hotwolf/Mini-BDM-Pod/RevB/Mini-BDM-Pod RevB Schematic.pdf

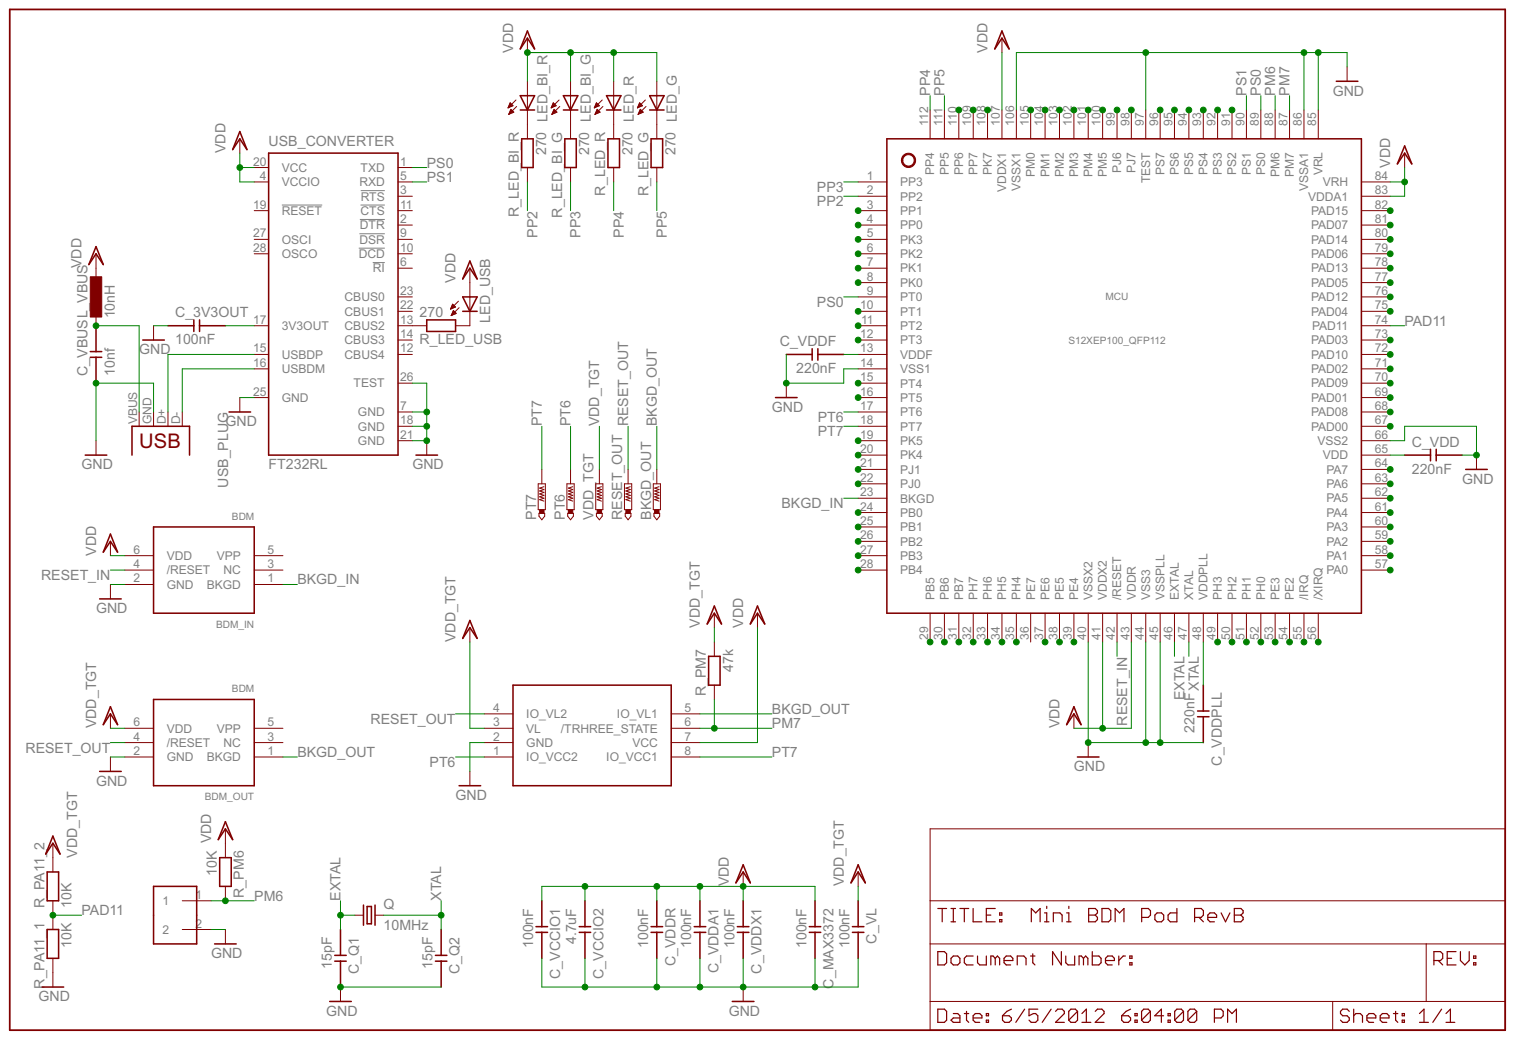
[picture p1: page 1]
