hotwolf/Mini-BDM-Pod/RevB/Mini-BDM-Pod RevB Mounting Plan.pdf

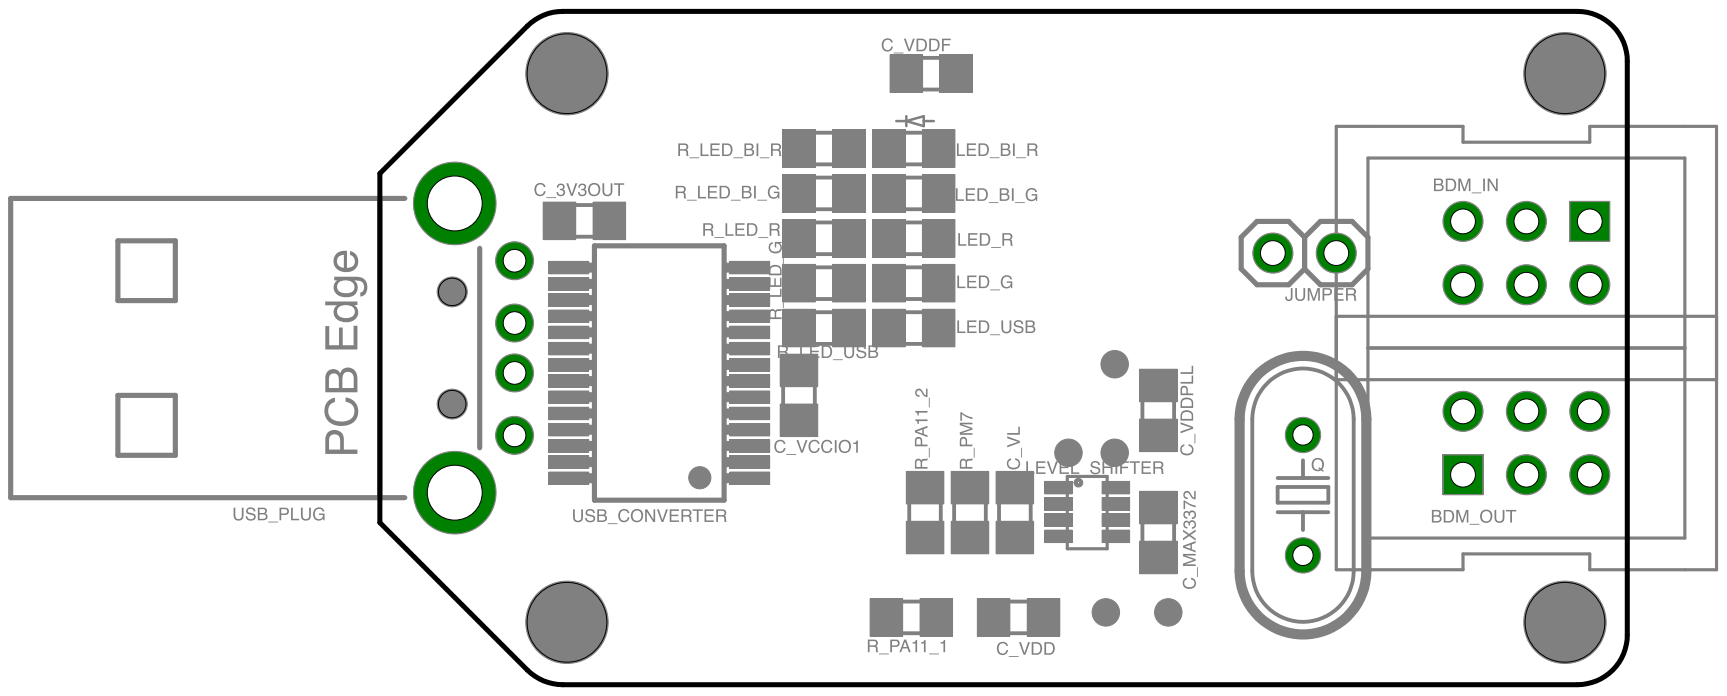
[picture p2: page 1]

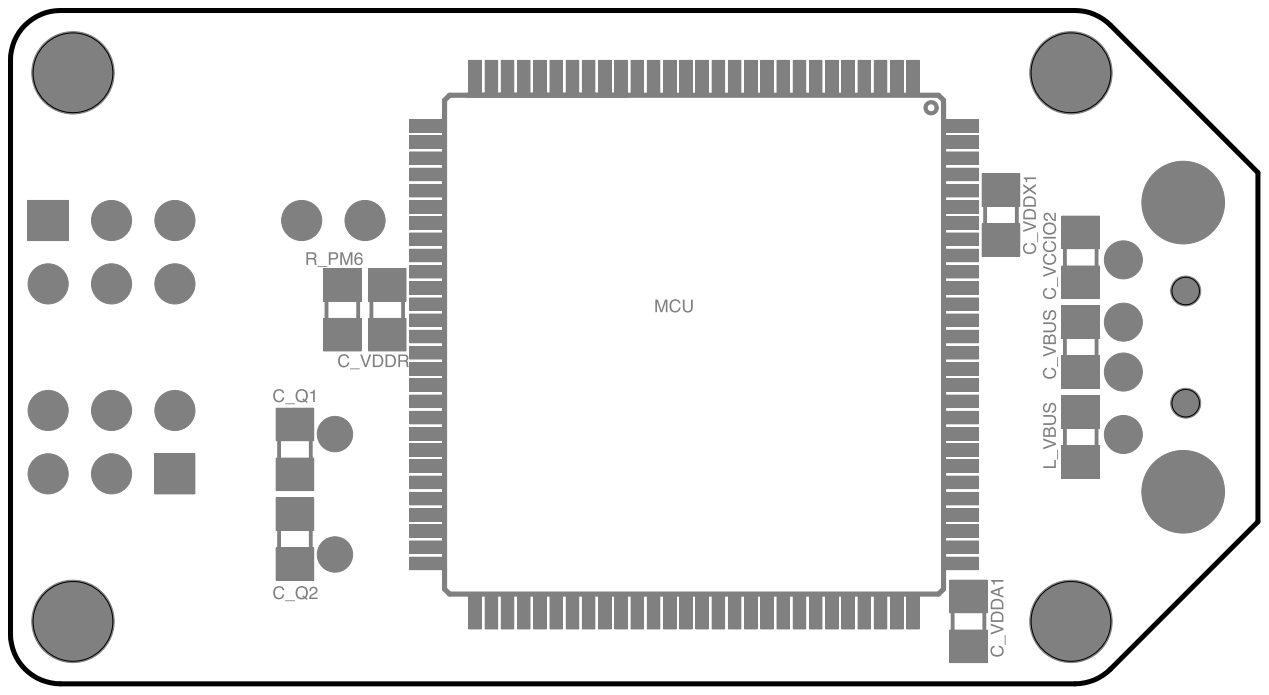
[picture p3: page 2]
