hotwolf/Mini-BDM-Pod/RevA/Mini-BDM-Pod RevA Schematic.pdf

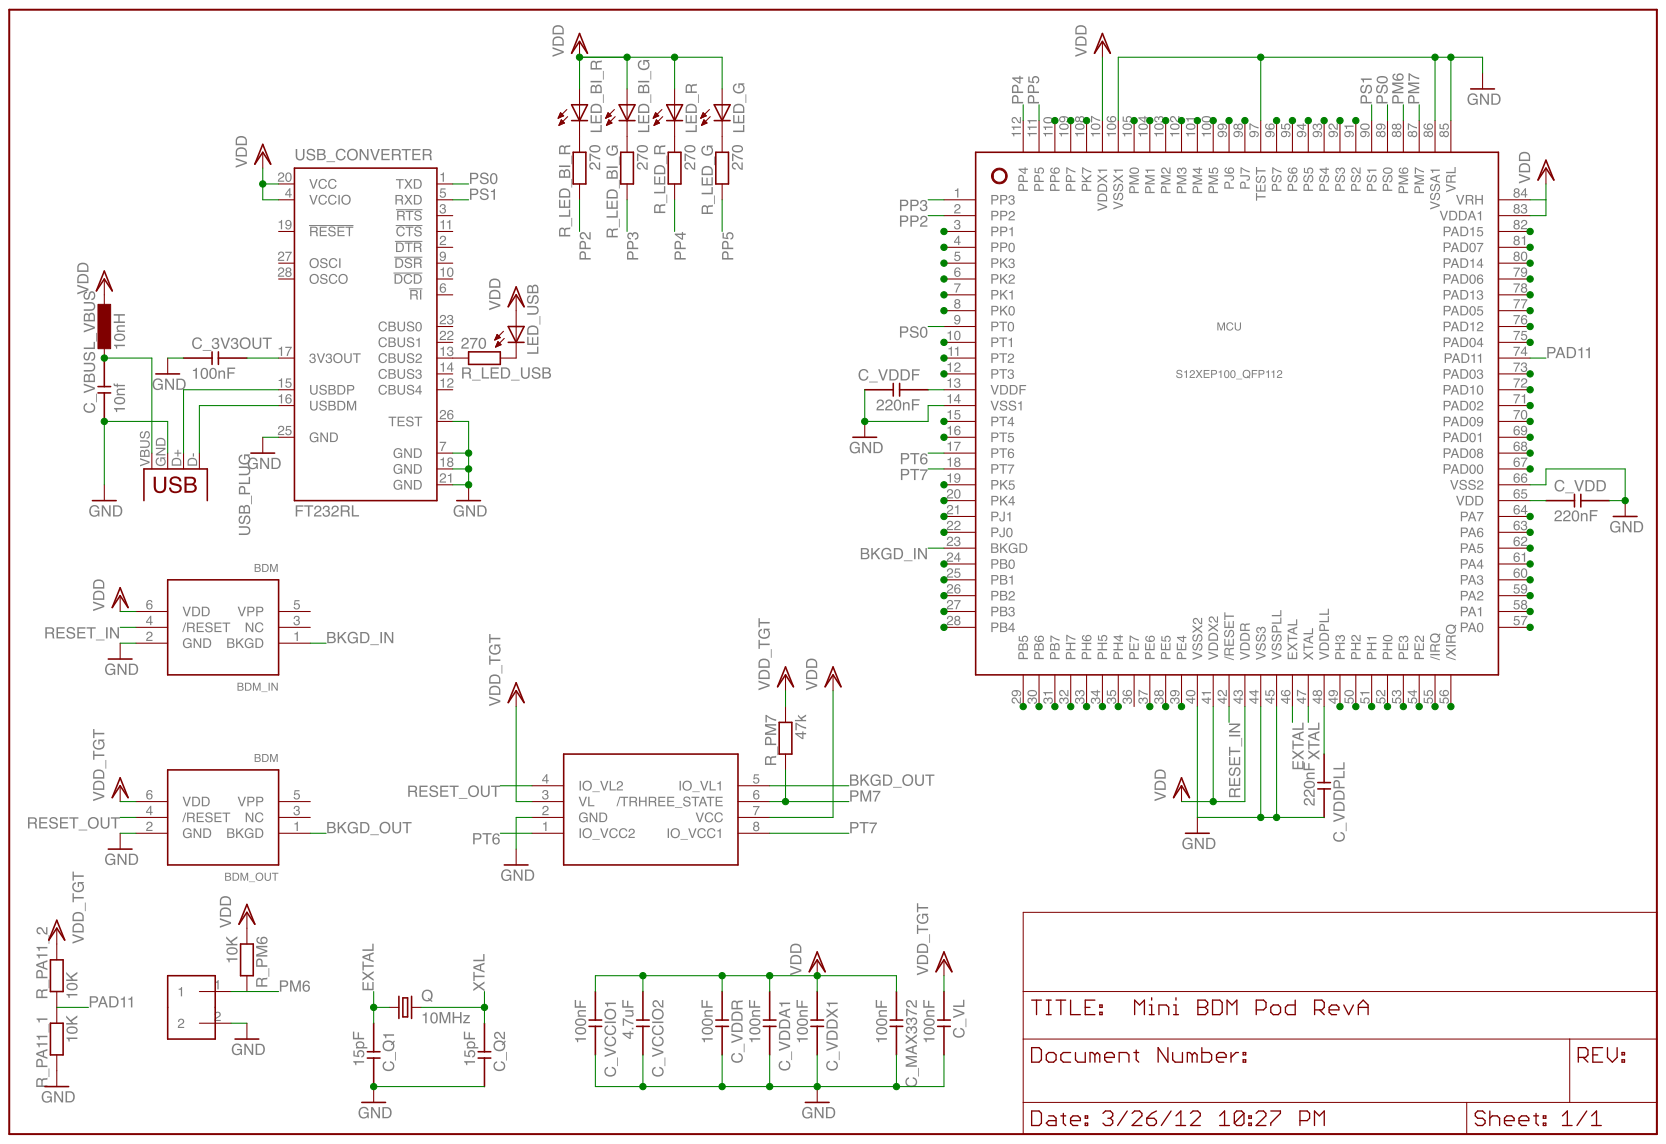
[picture p4: page 1]
