hotwolf/Mini-BDM-Pod/RevA/Mini-BDM-Pod RevA Mounting Plan.pdf

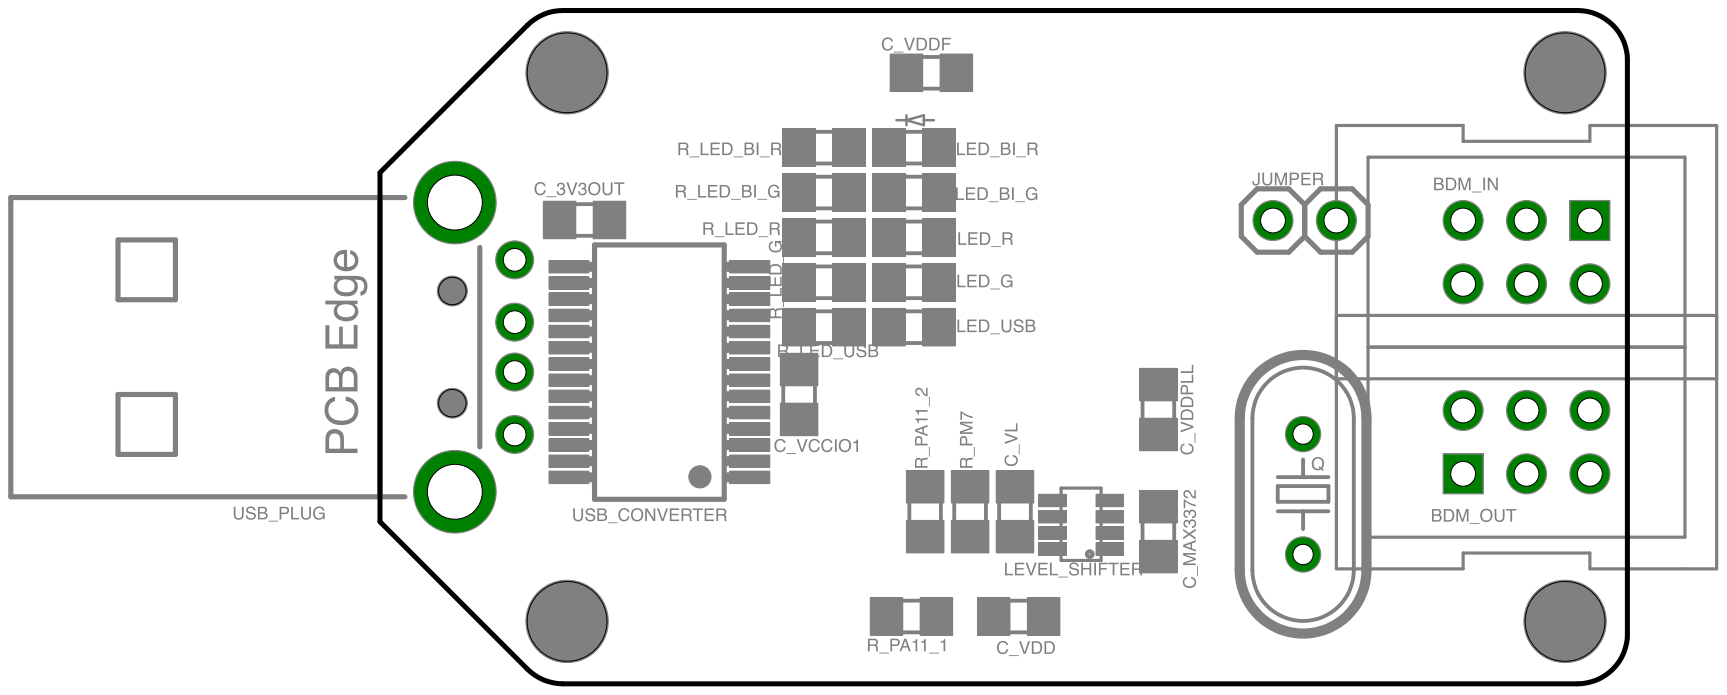
[picture p5: page 1]
