hotwolf/Mini-BDM-Pod/RevB/Mini-BDM-Pod RevB.brd

## EAGLE design RevB/Mini-BDM-Pod RevB.brd (2014-12-10)

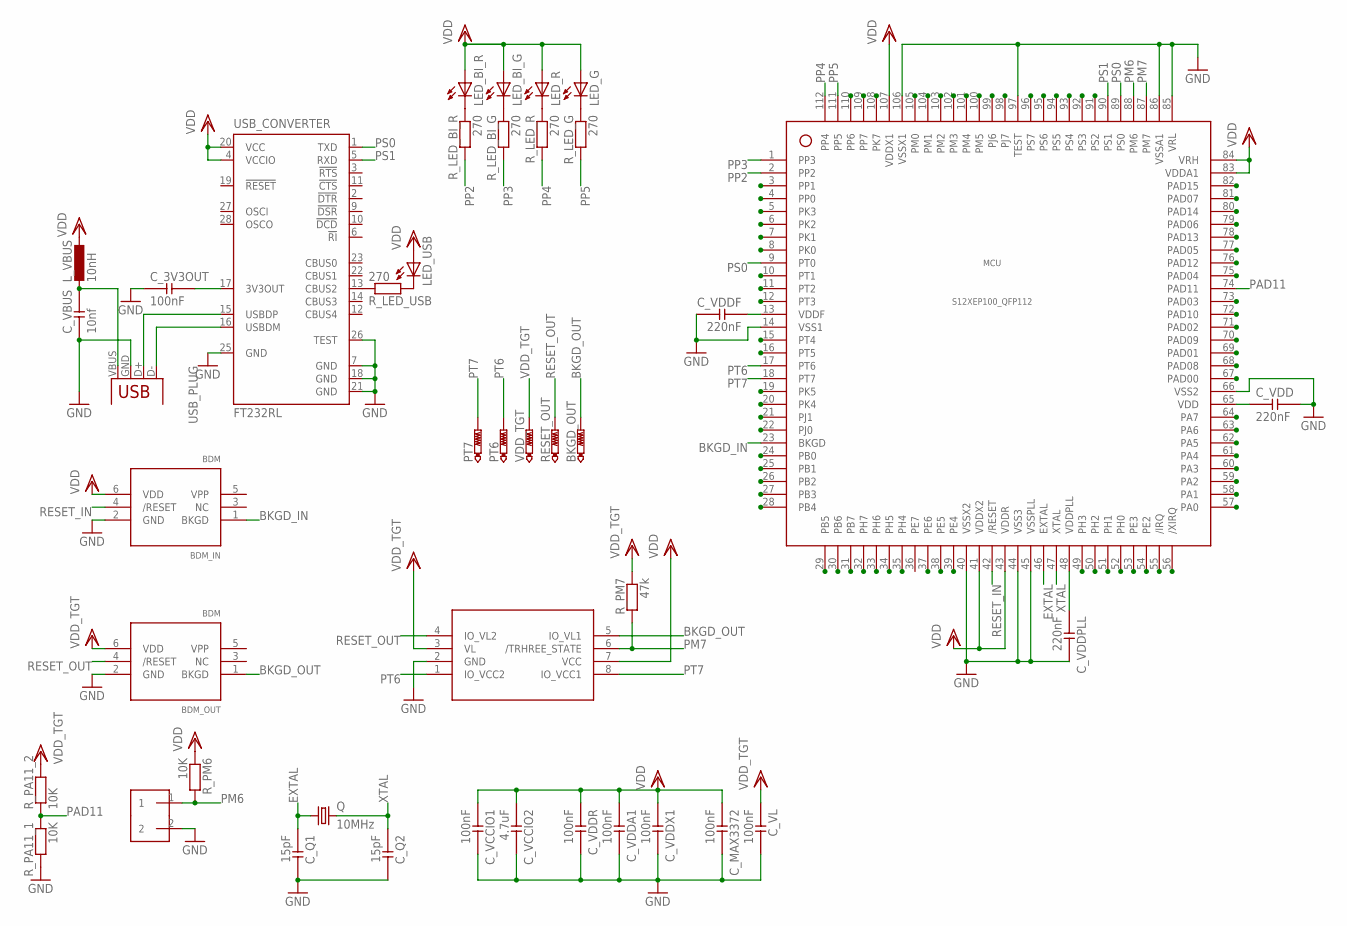
[picture p6: schematic Mini-BDM-Pod RevB.sch]

Parts:
BDM_IN: BDM
BDM_OUT: BDM
BKGD_OUT: PTR1TP10R; TP10R
C_3V3OUT: 100nF; 0805
C_MAX3372: 100nF; 0805
C_Q1, C_Q2: 15pF; 0805
C_VBUS: 10nf; 0805
C_VCCIO1: 100nF; 0805
C_VCCIO2: 4.7uF; 0805
C_VDD: 220nF; 0805
C_VDDA1: 100nF; 0805
C_VDDF: 220nF; 0805
C_VDDPLL: 220nF; 0805
C_VDDR: 100nF; 0805
C_VDDX1: 100nF; 0805
C_VL: 100nF; 0805
JUMPER: 1X2
LED_BI_G: LED0805; 0805
LED_BI_R: LED0805; 0805
LED_G: LED0805; 0805
LED_R: LED0805; 0805
LED_USB: LED0805; 0805
LEVEL_SHIFTER: MAX3373; SOT-23-MAXIM
L_VBUS: 10nH; 0805
MCU: S12XEP100_QFP112; QFP112
PT6, PT7: PTR1TP10R; TP10R
Q: 10MHz; HC49U70
RESET_OUT: PTR1TP10R; TP10R
R_LED_BI_G: 270; 0805
R_LED_BI_R: 270; 0805
R_LED_G: 270; 0805
R_LED_R: 270; 0805
R_LED_USB: 270; 0805
R_PA11_1, R_PA11_2: 10K; 0805
R_PM6: 10K; 0805
R_PM7: 47k; 0805
USB_CONVERTER: FT232RL; SSOP28
USB_PLUG: USB_PRINT-A; A
VDD_TGT: PTR1TP10R; TP10R

Connections:
3V3OUT: C_3V3OUT.1, USB_CONVERTER.17 (3V3OUT)
BKGD_IN: BDM_IN.1 (BKGD), MCU.23 (BKGD)
BKGD_OUT: BDM_OUT.1 (BKGD), BKGD_OUT.TP, LEVEL_SHIFTER.5 (IO_VL1)
D+: USB_CONVERTER.15 (USBDP), USB_PLUG.D+ (D-)
D-: USB_CONVERTER.16 (USBDM), USB_PLUG.D- (D+)
EXTAL: C_Q1.2, MCU.46 (EXTAL), Q.1
GND: BDM_IN.2 (GND), BDM_OUT.2 (GND), C_3V3OUT.2, C_MAX3372.1, C_Q1.1, C_Q2.1, C_VBUS.2, C_VCCIO1.1, C_VCCIO2.1, C_VDD.1, C_VDDA1.1, C_VDDF.1, C_VDDPLL.1, C_VDDR.1, C_VDDX1.1, C_VL.1, JUMPER.2, LEVEL_SHIFTER.2 (GND), MCU.14 (VSS1), MCU.40 (VSSX2), MCU.44 (VSS3), MCU.45 (VSSPLL), MCU.66 (VSS2), MCU.85 (VRL), MCU.86 (VSSA1), MCU.97 (TEST), MCU.106 (VSSX1), R_PA11_1.1, USB_CONVERTER.7 (GND), USB_CONVERTER.18 (GND), USB_CONVERTER.21 (GND), USB_CONVERTER.25 (GND), USB_CONVERTER.26 (TEST), USB_PLUG.GND (VBUS)
unnamed: R_LED_USB.2, USB_CONVERTER.13 (CBUS2)
unnamed: LED_USB.2 (C), R_LED_USB.1
unnamed: C_VBUS.1, L_VBUS.2, USB_PLUG.VBUS (GND)
unnamed: LED_BI_R.2 (C), R_LED_BI_R.2
unnamed: LED_BI_G.2 (C), R_LED_BI_G.2
unnamed: LED_R.2 (C), R_LED_R.2
unnamed: LED_G.2 (C), R_LED_G.2
PAD11: MCU.74 (PAD11), R_PA11_1.2, R_PA11_2.2
PM6: JUMPER.1, MCU.88 (PM6), R_PM6.1
PM7: LEVEL_SHIFTER.6 (/TRHREE_STATE), MCU.87 (PM7), R_PM7.1
PP2: MCU.2 (PP2), R_LED_BI_R.1
PP3: MCU.1 (PP3), R_LED_BI_G.1
PP4: MCU.112 (PP4), R_LED_R.1
PP5: MCU.111 (PP5), R_LED_G.1
PS0: MCU.9 (PT0), MCU.89 (PS0), USB_CONVERTER.1 (TXD)
PS1: MCU.90 (PS1), USB_CONVERTER.5 (RXD)
PT6: LEVEL_SHIFTER.1 (IO_VCC2), MCU.17 (PT6), PT6.TP
PT7: LEVEL_SHIFTER.8 (IO_VCC1), MCU.18 (PT7), PT7.TP
RESET_IN: BDM_IN.4 (/RESET), MCU.42 (/RESET)
RESET_OUT: BDM_OUT.4 (/RESET), LEVEL_SHIFTER.4 (IO_VL2), RESET_OUT.TP
VDD: BDM_IN.6 (VDD), C_MAX3372.2, C_VCCIO1.2, C_VCCIO2.2, C_VDDA1.2, C_VDDR.2, C_VDDX1.2, LED_BI_G.1 (A), LED_BI_R.1 (A), LED_G.1 (A), LED_R.1 (A), LED_USB.1 (A), LEVEL_SHIFTER.7 (VCC), L_VBUS.1, MCU.41 (VDDX2), MCU.43 (VDDR), MCU.83 (VDDA1), MCU.84 (VRH), MCU.107 (VDDX1), R_PM6.2, USB_CONVERTER.4 (VCCIO), USB_CONVERTER.20 (VCC)
VDDF: C_VDDF.2, MCU.13 (VDDF)
VDDI: C_VDD.2, MCU.65 (VDD)
VDDPLL: C_VDDPLL.2, MCU.48 (VDDPLL)
VDD_TGT: BDM_OUT.6 (VDD), C_VL.2, LEVEL_SHIFTER.3 (VL), R_PA11_2.1, R_PM7.2, VDD_TGT.TP
XTAL: C_Q2.2, MCU.47 (XTAL), Q.2

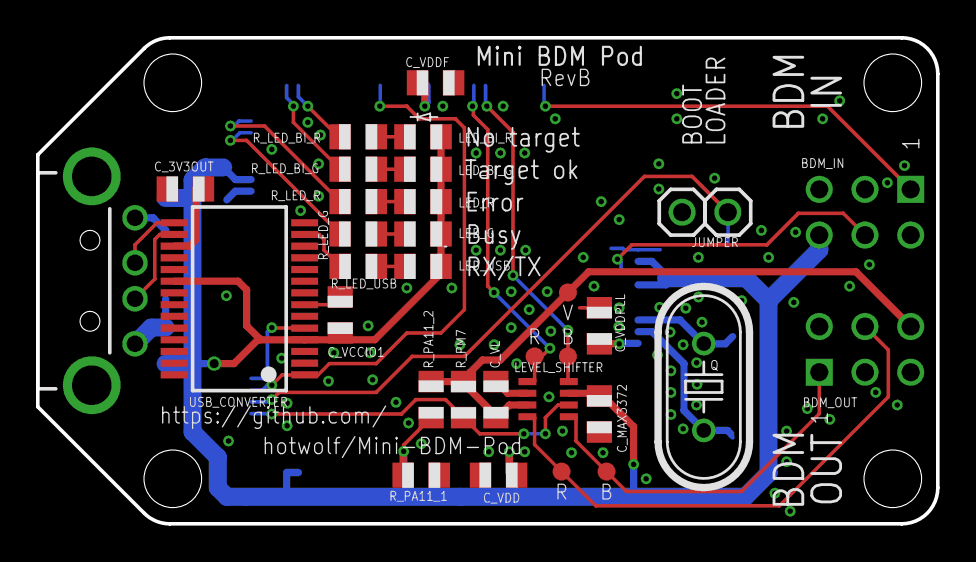
[picture p7: board Mini-BDM-Pod RevB.brd from above]

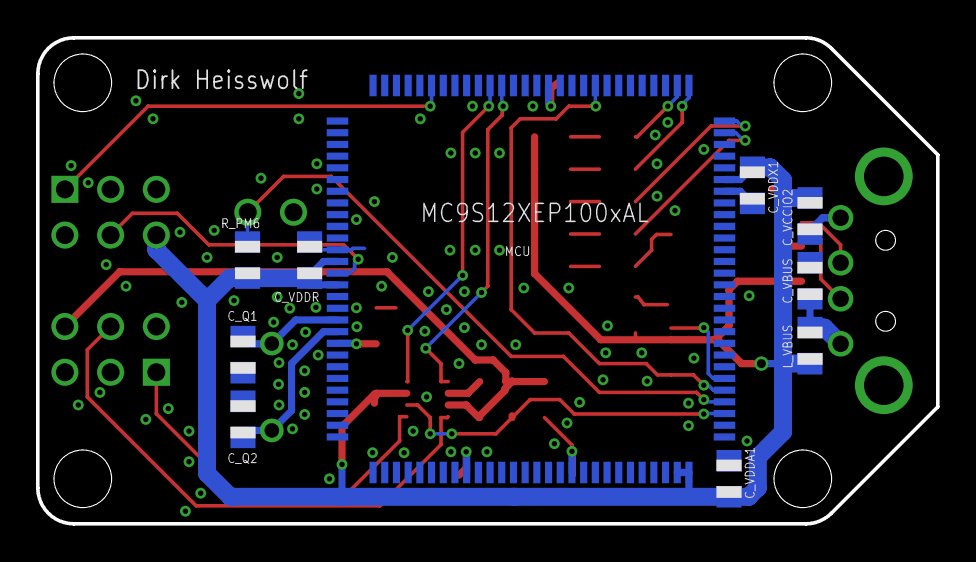
[picture p8: board Mini-BDM-Pod RevB.brd from below]

Board: 2 copper layers, 50.0 x 27.0 mm, 42 parts (10 on the bottom side), 33 nets.
