hotwolf/Mini-BDM-Pod/(commit log)

2012-03-25 initial release (rev. A)
    [Mini BDM Pod RevA.brd, Mini BDM Pod RevA.sch]
2012-03-25 added Gerber files
2012-03-26 added BOM
2012-03-26 prepared mounting diagram
    [Mini BDM Pod RevA.brd, Mini BDM Pod RevA.sch]
2012-03-26 added schematic and mounting plan
2012-03-27 mirrored bottom names for mounting plan
    [Mini BDM Pod RevA.brd, Mini BDM Pod RevA.sch]
2012-03-28 fixed mounting plan
    [Mini BDM Pod RevA.brd]
2012-05-08 added RevB
    [Mini BDM Pod RevB.brd, Mini BDM Pod RevB.sch]
2012-05-08 added mounting plan and Gerber files
    [Mini BDM Pod RevB.brd]
2012-06-05 added RevB schematic
2014-09-17 rearranged directories
    [Mini BDM Pod RevA.brd, Mini BDM Pod RevA.sch, Mini BDM Pod RevB.brd, Mini BDM Pod RevB.sch]
2014-09-18 fixed file names
    [Mini-BDM-Pod RevA.brd, Mini-BDM-Pod RevA.sch, Mini-BDM-Pod RevB.brd, Mini-BDM-Pod RevB.sch]
2014-12-10 removed order number from layout
    [Mini-BDM-Pod RevB.brd]
